dducret/WindSpots-Hardware/build/SensorCard/SensorCard.jpg

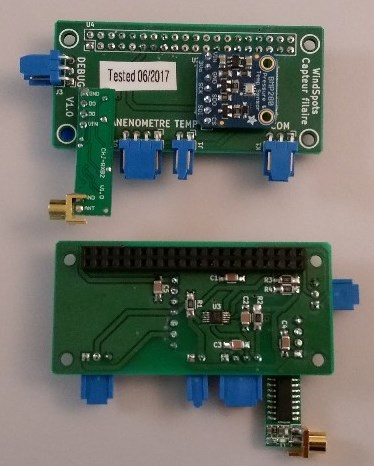
build/SensorCard/SensorCard.jpg
