dducret/WindSpots-Hardware/documentation/Connection Console.jpg

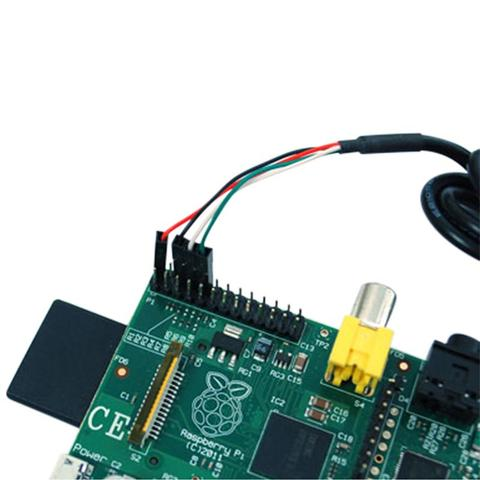
documentation/Connection Console.jpg
