dducret/WindSpots-Hardware/README.md

# WindSpots-Hardware
All information, schema, source code for building a WindSpots Weather Station
