dducret/WindSpots-Hardware/documentation/README.md

# Documentation WindSpots MeteoStation

Ce repertoire regroupe la documentation d'installation, d'exploitation et de maintenance de la station meteo WindSpots.

## Guides disponibles

- [Installation de base sur Raspberry Pi 3](installation-base-raspberry-pi-3.md)
- [Interface web de configuration](wui-configuration.md)
- [Initialisation de la base meteo](initwsdb.md)
- [Tests cible apres installation](tests-cible.md)
