dducret/WindSpots-Hardware/documentation/Component WindSpots 2017 v6.xlsx

Sheet: Carte w2rpi
Quantité | Fournisseur | Référence | Description | Prix net | Prix | Total | 47.32
1 | Leiton | PCB - 83307-1 | Carte PCB | 9.00 | 9.95 | 9.95
1 | Farnell | ADS1015IDGST | ADS1015 | 2.75 | 3.50 | 3.50
1 | DigiKey | CONMCX003.031-ND | MCX Antenne | 3.30 | 3.98 | 3.98
3 | Distrelec | 300-56-914 | 10k | 0.03 | 0.03 | 0.09
1 | Distrelec | 300-57-004 | 4.7k | 0.03 | 0.03 | 0.03
5 | Distrelec | 300-66-372 | 100nF | 0.13 | 0.13 | 0.67
1 | RS Components | 125-8208 | QAM-RX10-433 | 2.41 | 2.41 | 2.41
1 | Adafruit | 2651 | BMP280 | 8.96 | 8.96 | 8.96 |  | Mouser | 485-2651 | 9.13
1 | Adafruit | 2243 | barrette 40 pôles | 1.76 | 1.76 | 1.76 |  | Farnell | 1528-1785-ND | 1.33
1 | Distrelec | 143-01-686 | DUBOX 2 pôles | 0.50 | 0.50 | 0.50
2 | Distrelec | 143-01-687 | DUBOX 3 pôles | 0.49 | 0.49 | 0.98
1 | Distrelec | 143-01-688 | DUBOX 4 pôles | 0.77 | 0.77 | 0.77
1 | Distrelec | 143-01-700 | DUBOX femelle 2 pôles | 0.21 | 0.21 | 0.21
2 | Distrelec | 143-01-701 | DUBOX femelle 3 pôles | 0.21 | 0.21 | 0.42
1 | Distrelec | 143-01-702 | DUBOX femelle 4 pôles | 0.34 | 0.34 | 0.34
12 | Distrelec | 143-01-729 | Sertissage DUBOX femelle | 0.17 | 0.17 | 2.04
1 | Adafruit | 1531 | MCX Jack to BNC | 5.36 | 5.36 | 5.36
1 |  |  | Frais de port | 89.00 | 89.00 | 2.97
1 |  |  | Douane | 71.75 | 71.75 | 2.39

Sheet: Carte Alim
Quantité | Fournisseur | Référence | Description | Prix net | Prix | Total | 51.59
1 | Ecole | PCB | Carte PCB | 10.00 | 10.00 | 10.00
4 | Distrelec | 300-56-914 | 10 k [Ω] | 0.03 | 0.03 | 0.12
1 | Distrelec | 300-56-934 | 2 k [Ω] | 0.03 | 0.03 | 0.03
1 | Distrelec | 300-37-183 | 0.01 [Ω] 3W | 0.95 | 0.95 | 0.95
1 | Farnell | 2139689 | 910k [Ω] | 0.08 | 0.08 | 0.08
1 | Distrelec | 300-37-190 | 0.1 [Ω] 0.3W | 0.25 | 0.25 | 0.25
1 | Distrelec | 300-56-936 | 220 [Ω] | 0.03 | 0.03 | 0.03
2 | Distrelec | 300-56-984 | 10 [Ω] | 0.03 | 0.03 | 0.05
1 | Distrelec | 300-37-189 | 0.1 [Ω] 3 W | 0.95 | 0.95 | 0.95
6 | Distrelec | 300-66-372 | 100 nF | 0.11 | 0.11 | 0.68
3 | Distrelec | 300-66-117 | 10 uF | 0.13 | 0.13 | 0.40
1 | Farnell | 9227865 | 1uF | 0.14 | 0.14 | 0.14
2 | Distrelec | 300-13-748 | 100uF | 0.38 | 0.38 | 0.77
1 | Distrelec | 173-04-265 | 555 | 0.22 | 0.22 | 0.22
1 | Farnell | 1470502 | PTH080880 | 8.57 | 8.57 | 8.57
1 | Distrelec | 300-55-984 | MCP1826 | 0.77 | 0.77 | 0.77 |  | Farnell | 1578424 | 0.57
5 | Farnell | 2496402 | INA219 | 1.98 | 1.98 | 9.90
5 | Distrelec | 148-40-952 | BORNIER 2 pôles | 0.59 | 0.59 | 2.95
1 | Distrelec | 142-70-880 | port USB | 1.05 | 1.05 | 1.05
2 | Distrelec | 300-43-381 | support fusible | 0.39 | 0.39 | 0.79
1 | Distrelec | 143-01-686 | DUBOX 2 pôles | 0.50 | 0.50 | 0.50
1 | Distrelec | 143-01-687 | DUBOX 3 pôles | 0.49 | 0.49 | 0.49
1 | Distrelec | 175-22-735 | Phototransistor | 0.25 | 0.25 | 0.25
2 | Distrelec | 300-57-629 | Diode schottky PMEG6010CEH | 0.31 | 0.31 | 0.62
1 | Distrelec | 170-10-283 | Diode schottky 1N5819 | 0.26 | 0.26 | 0.26
1 | Distrelec | 164-36-000 | Potentiomètre | 0.39 | 0.39 | 0.39
1 | Distrelec | 171-01-432 | MOSFET BSP76 | 0.81 | 0.81 | 0.81
1 | Distrelec | 300-43-490 | Fusible 2 A | 0.20 | 0.20 | 0.20
1 | Distrelec | 133-16-866 | Fusible 15 A | 0.30 | 0.30 | 0.30
1 | Distrelec | 143-01-700 | DUBOX femelle 2 pôles | 0.21 | 0.21 | 0.21
1 | Distrelec | 143-01-701 | DUBOX femelle 3 pôles | 0.21 | 0.21 | 0.21
5 | Distrelec | 143-01-729 | Sertissage DUBOX femelle | 0.17 | 0.17 | 0.85
1 | Distrelec | 148-15-663 | Socle 555 | 1.00 | 1.00 | 1.00
1 |  |  | Frais de port | 34.05 | 34.05 | 6.81
1 |  |  | Douane | 0 | 0 | 0

Sheet: WS Station
Quantité | Fournisseur | Référence | Description | Prix net | Total | 314.62
1 | Farnell | 2525225 | Raspberry PI 3 | 35.29 | 35.29
1 | Distrelec |  | Carte Micro SD 4GB | 5.13 | 5.13
1 | WindSpots | WS200 | w2rpi | 47.32 | 47.32
1 | FNAC |  | Lentille UV 52mm | 17.90 | 17.90
1 | Conrad | 284324-62 | Capteur de température MJSPJY-223-3950-1-600-3D | 9.95 | 9.95
1 | Perillat SA | M 10 BN 137 | Ecrou petit filletage | 0.25 | 0.25
1 | Alltron | 253525 | Camera Logitech C930e | 102.45 | 102.45
1 | Swibox |  | Boite | 19.70 | 19.70
1 | Radio Matériel | BT-V112 | Support | 23.20 | 23.20
4 |  |  | Rivet pop | 0.20 | 0.80
1 | Promatelec |  | Presse étoupe M16 | 0.75 | 0.75
1 | Distrelec | 303139 | Ventilateur à Membrane | 9.20 | 9.20
1 | Distrelec | 506104 | Ecrou pour Ventilateur M12 x 1.5 | 0.35 | 0.35
1 | Distrelec | 221014 | Prise RJ45 pour Anémomètre filaire M22-RJ45-SA | 28.30 | 28.30
1 | WindSpots |  | Câble RJ11 - Dubox 4 pôles | 1.70 | 1.70
0 | Conrad | 181895 | Sachet absorbeur d'humidité 181895 3 g | 0.17 | 0.00
1 | Adafruit | 1531 | Cable BNC - MCX jack | 5.95 | 5.95
 | Distrelec | 148-01-791 | Entretoise 8mm | 0.35
4 | Distrelec | 148-01-196 | Entretoise 10mm 5mm | 0.44 | 1.75
4 | Distrelec | 148-01-794 | Entretoise 10mm 5mm | 0.35 | 1.39
4 | Distrelec | 110-76-305 | Entretoise 20mm 5mm | 0.67 | 2.67
4 | Distrelec | 110-76-375 | Vis tete fendue 6mm | 0.14 | 0.55
0 | Distrelec | 300-71-990 | Vis tete philipps 8mm / 100 pièces | 4.60 | 0.00
 | Distrelec | 300-71-989 | Vis tete philipps 10mm / 100 pièces | 3.00 | 0.00
 | Distrelec | 301-13-355 | Presse etoupe M 12 | 1.47 | 0.00
 | Distrelec | 301-13-356 | Presse etoupe M 16 | 1.79 | 0.00

Sheet: Options
Quantité | Fournisseur | Référence | Description | Prix net | Total
STATION | WindSpots |  | Station de Base |  | 314.62 | 314.62
SOLAIRE |  |  |  |  |  | 307.67
1 | Conrad | 1216562 | Phocos 321199 | 48.10 | 48.10
1 | Conrad | 250914 | Batterie Plomb 12V 5aH | 36.99 | 36.99
1 | WindSpots | WS300 | Alimentation WindSpots | 51.59 | 51.59
1 | Distrelec | 155-18-890 | Presse Etoupe PG11 4...10 mm 8 mm | 0.99 | 0.99
1 |  |  | Panneau Solaire 20W | 120.00 | 120.00
1 |  |  | Support Panneau Solaire (Antenne Satelitte) | 50.00 | 50.00
POE |  |  |  |  |  | 145.30
1 | Digitec | 353093 | Trendnet TPE-113GI, Gigabit PoE-Injector | 33.70 | 33.70
1 | Digitec | 5656488 | Trendnet TPE-104GS Gigabit PoE | 35.40 | 35.40
1 | Adafru.it | 2727 | Jack to microUSB | 2.5 | 2.50
1 | Maxxtro | 125-11-222 | Network cable | 7.1 | 7.10
1 | Distrelec | 144-67-015 | Fiche RJ45 Accouplement | 30.9 | 30.90
1 | Distrelec | 144-67-007 | Douille RJ45 | 15.7 | 15.70
20 |  |  | Cable RJ45 | 1 | 20.00
220V |  |  |  |  |  | 28.73
1 | Distrelec | 169-05-904 | Bloc d'alimentation | 11.90 | 11.90
1 | Conrad | 595240 | MicroUsb adaptater | 5.90 | 5.90
2 | Distrelec | 155-18-890 | Presse Etoupe PG11 4...10 mm 8 mm | 0.99 | 1.98
1 | Distrelec | 300-64-471 | Boite | 4.35 | 4.35
5 | Distrelec | 155-91-519 | Cable coax | 0.92 | 4.60
3G |  |  |  |  |  | 166.70
1 | Alltron | 236872 | USB 3G | 41.40 | 41.40
1 | Alltron | 237516 | Coax pgtail for 3G | 17.75 | 17.75
1 | Alltron | 175002 | GSM Antenne 3G | 107.55 | 107.55
433Mhz |  |  |  |  |  | 380.95
1 | Radioworld.ca | WMR200 | Oregon WMR 200 + Port | 350.00 | 350.00
1 | Conrad | 115142 | Petite Antenne | 30.95 | 30.95
0 | Conrad | 190073 | Moyenne Antenne | 50.95 | 0.00
0 | Aquatel | AQ920-7 | Antenna Booster Kit | 135.00 | 0.00
Filaire |  |  |  |  |  | 155.00
1 | Meteo-Shop.ch | 6410 | Anémomètre Davis Vantage Pro2 | 155.00 | 155.00
