dducret/WindSpots-Hardware/build/SensorCard/SensorCard-Schema.pdf

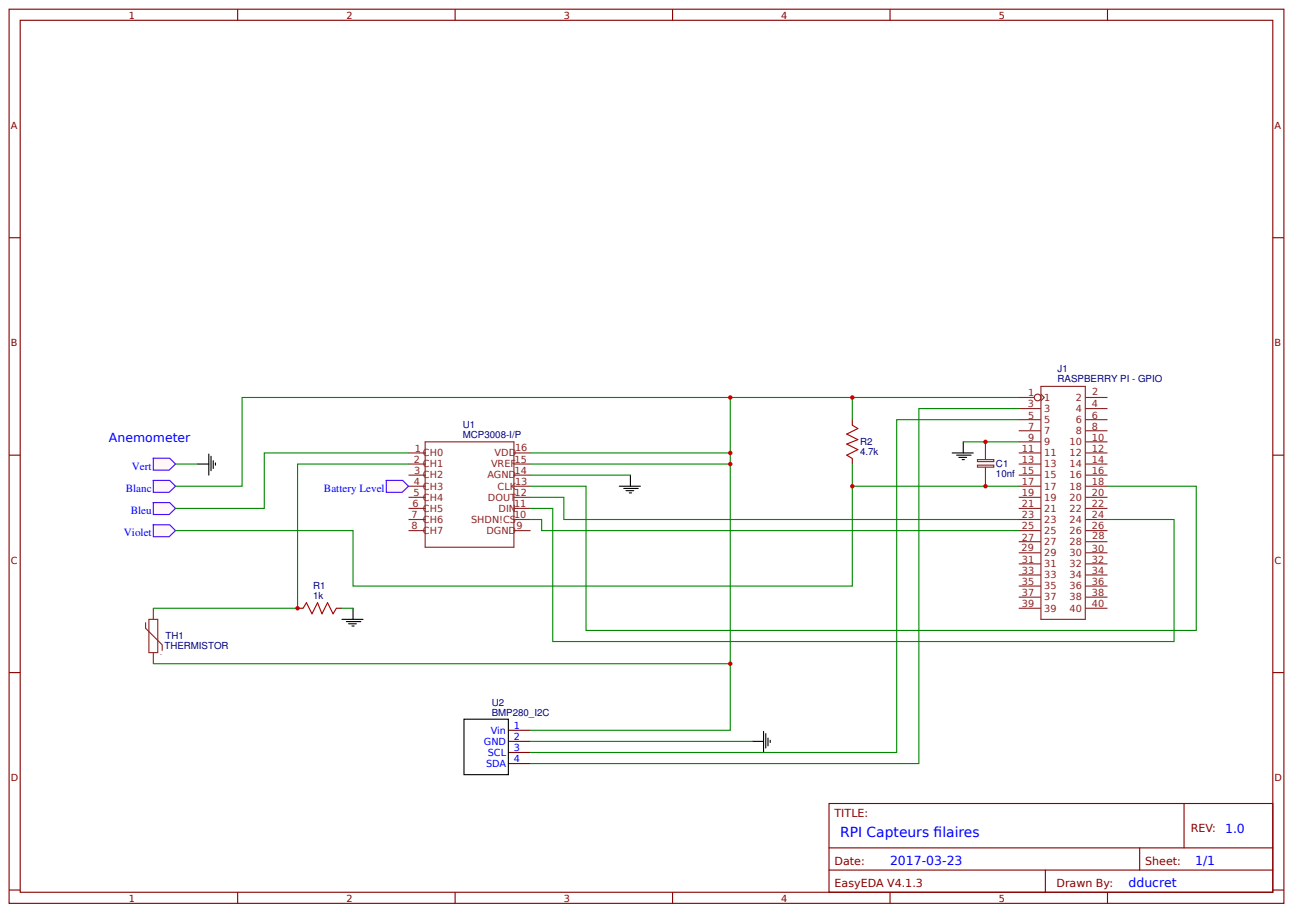
[picture p3: page 1]
TITLE:; RPI Capteurs filaires; REV: 1.0; Date:; Sheet: 1/1; EasyEDA V4.1.3; Drawn By:; dducret; MCP3008-I/P; DGND9 SHDN!CS10 DIN11 DOUT12 CLK13 AGND14 VREF15 VDD16; Vert; Blanc; Bleu; Violet; Anemometer; BMP280_I2C; Vin 1 GND 2 SCL 3 SDA 4; RASPBERRY PI - GPIO; THERMISTOR; Battery Level
