dducret/WindSpots-Hardware/documentation/Schema_alimentation_panneau_solaire.pdf

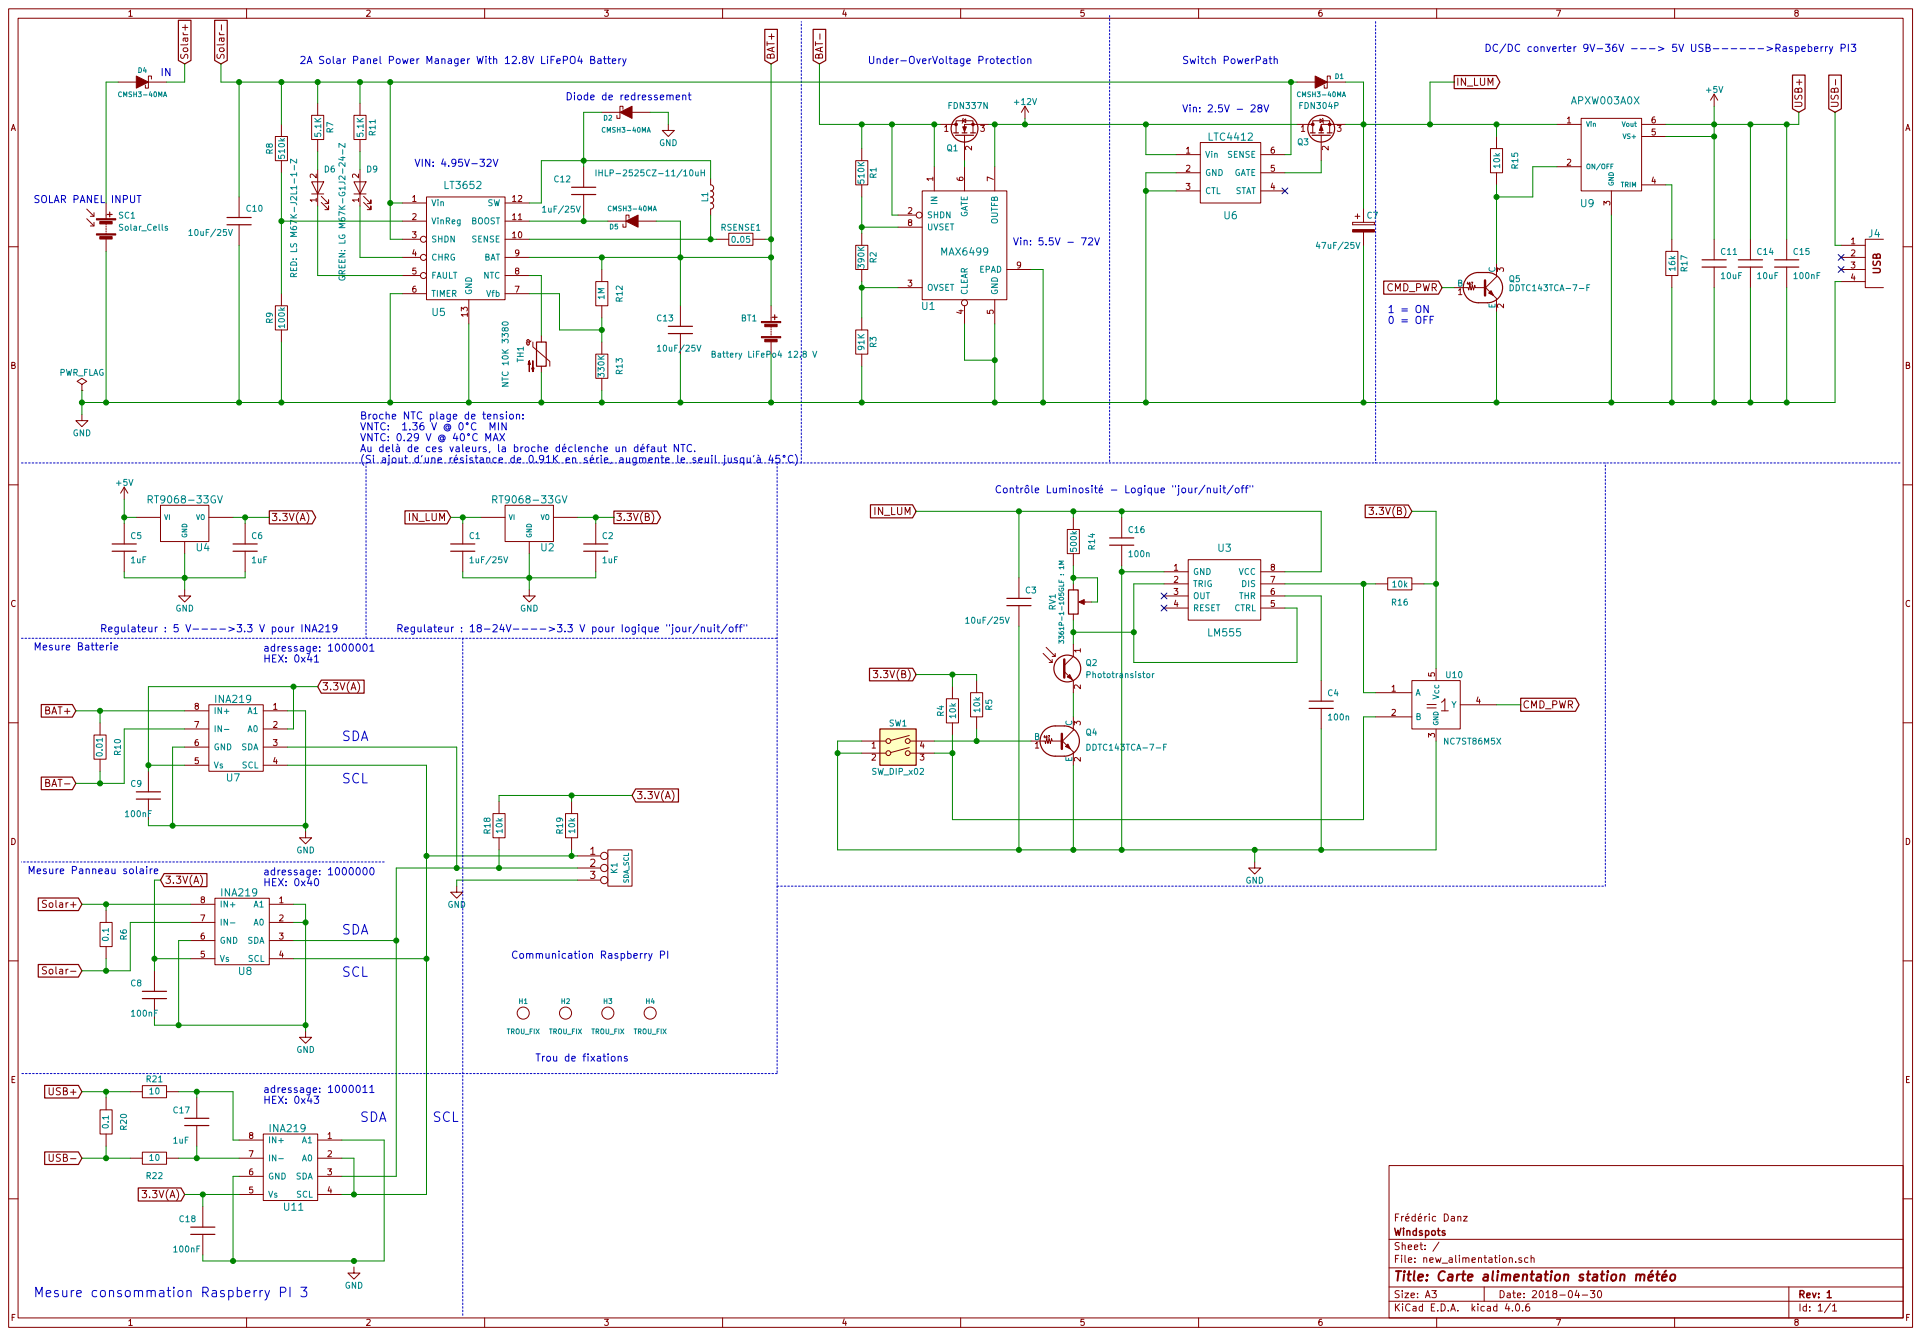
[picture p4: page 1]

DC/DC converter 9V-36V ---> 5V USB------>Raspeberry PI3

1 2D9 GREEN: LG M67K-G1J2-24-Z 1 2D6 RED: LS M67K-J2L1-1-Z 5.1K R7 5.1K R11 D5CMSH3-40MA BT1 Battery LiFePo4 12.8 V Mesure Panneau solaire

47uF/25V Broche NTC plage de tension:

10uF Regulateur : 18-24V---->3.3 V pour Iogique "jour/nuit/off"

(Si ajout d'une résistance de 0.91K en série, augmente le seuil jusqu'à 45°C) TH1 NTC 10K 3380

VNTC: 1.36 V @ 0°C MIN
VNTC: 0.29 V @ 40°C MAX
Au delà de ces valeurs, la broche déclenche un défaut NTC.

LM555 Contrôle Luminosité - Logique "jour/nuit/off"

1 2 Q2Phototransistor GND GND GND GND GND SDA

File: new_alimentation.sch Sheet: / Windspots Frédéric Danz

Id: 1/1 Title: Carte alimentation station météo
