dducret/WindSpots-Hardware/build/SolarPowerCard/Schema.pdf

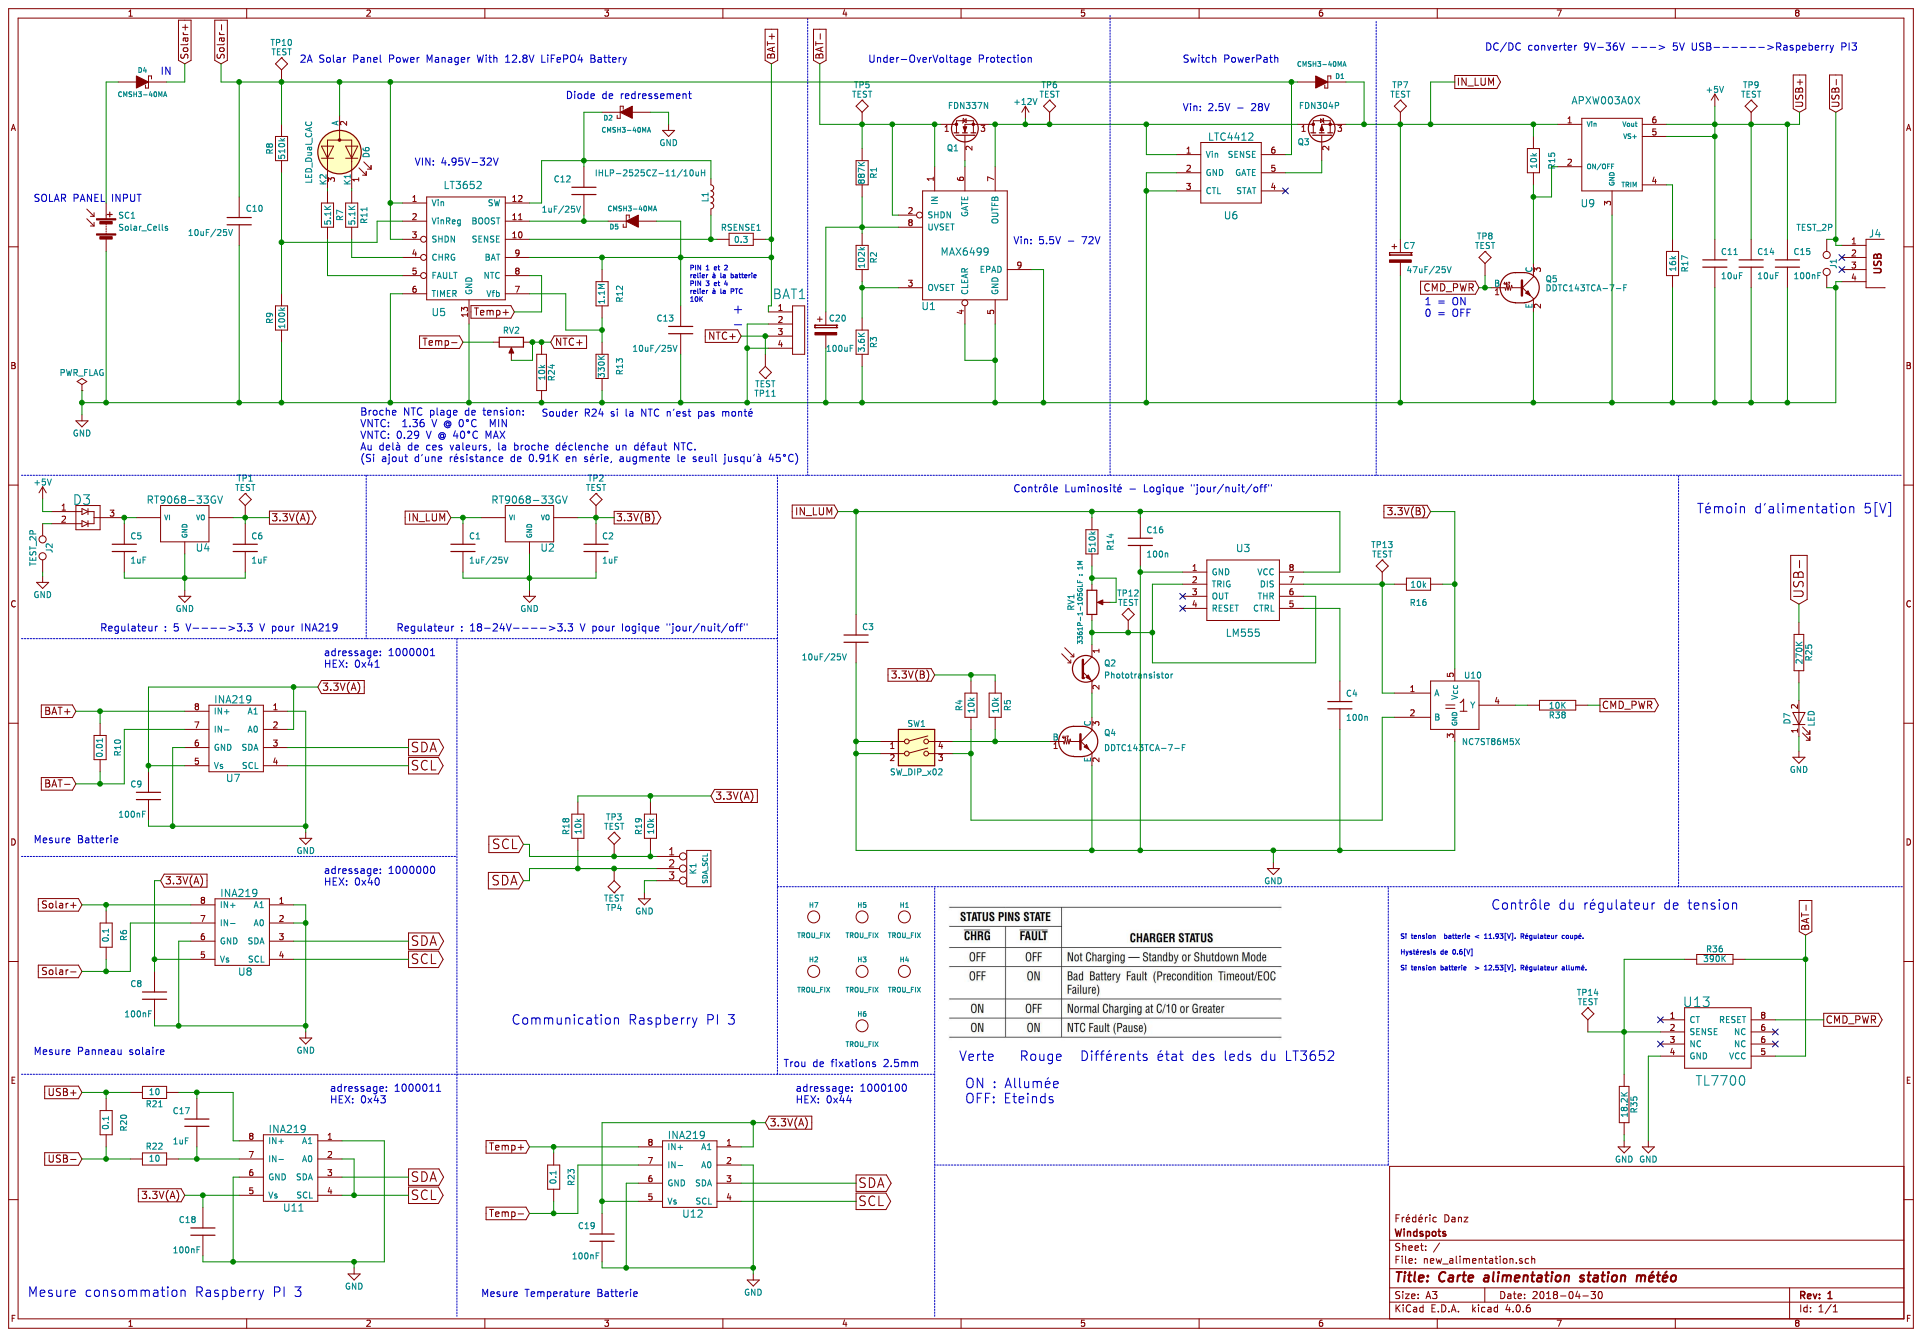
[picture p5: page 1]
