dducret/WindSpots-Hardware/documentation/RPI_capteur_filaires.pdf

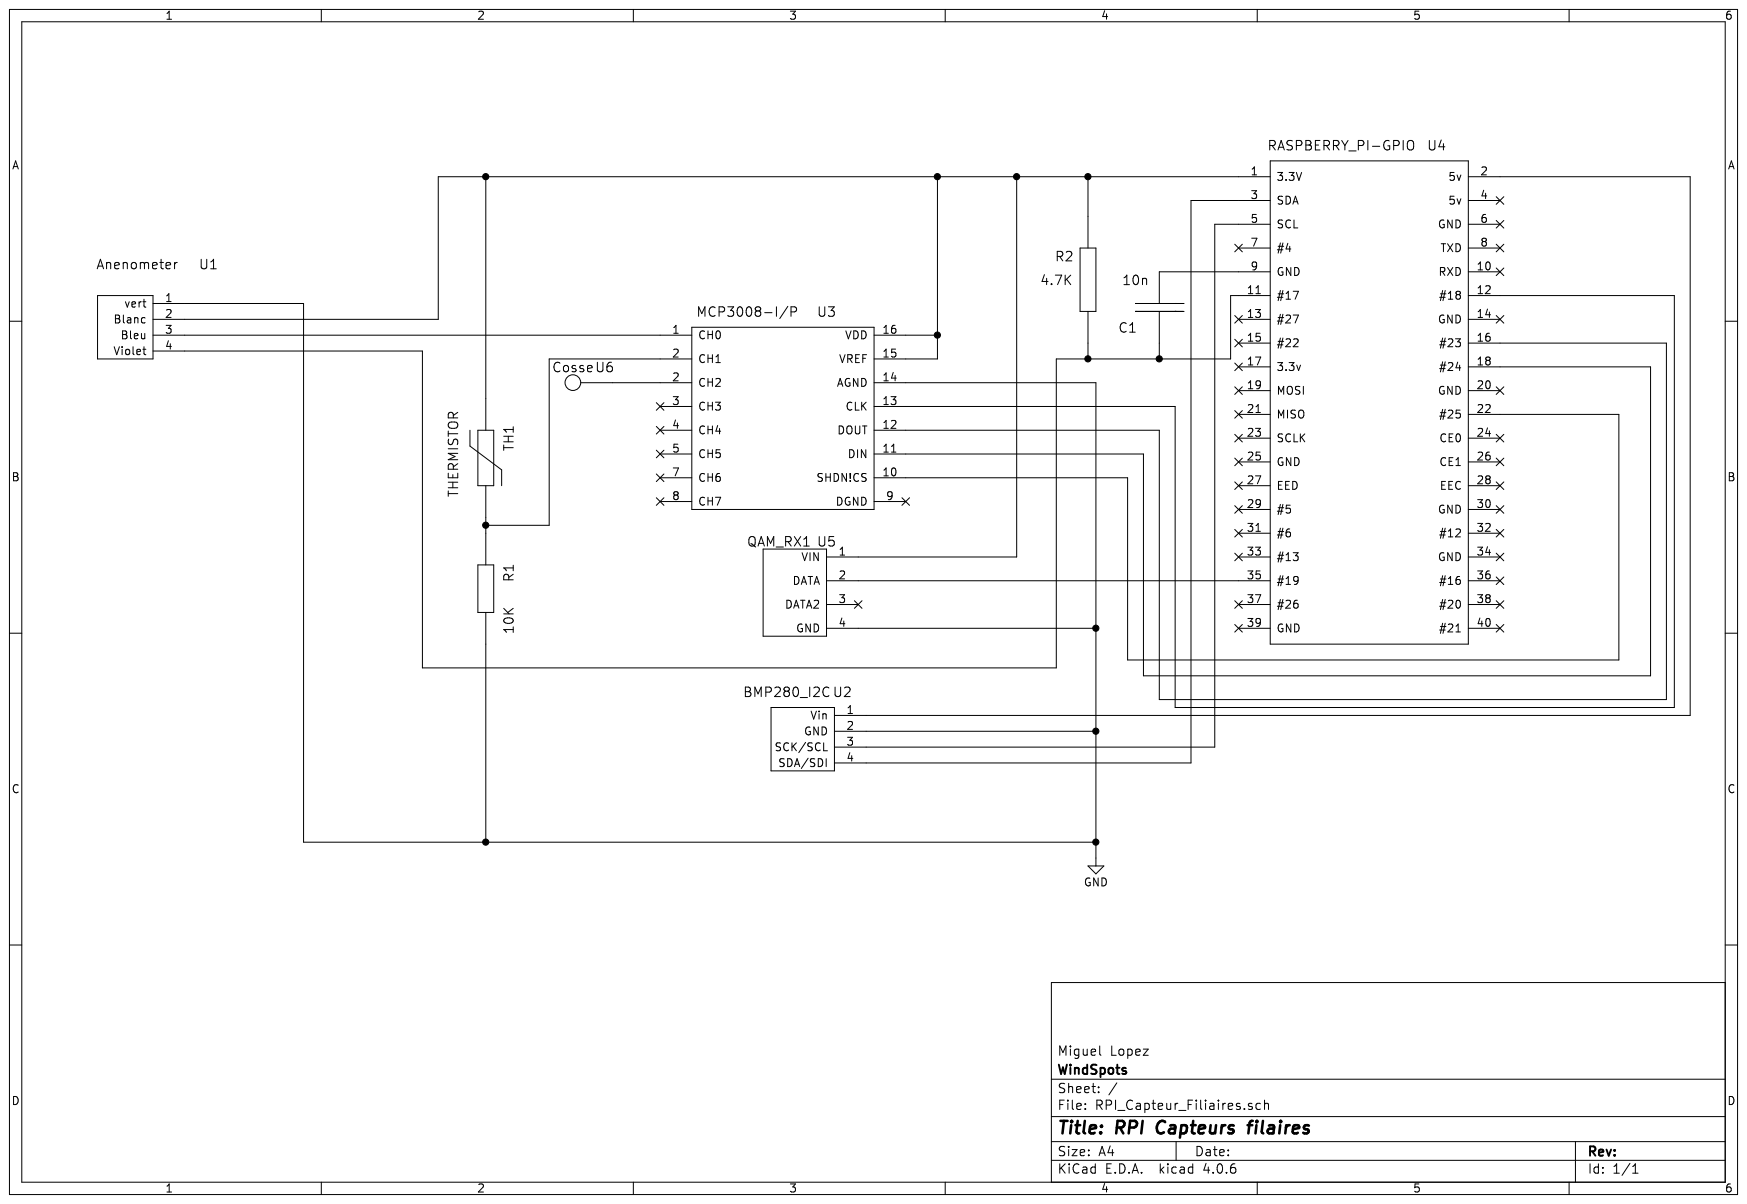
[picture p6: page 1]
