dducret/WindSpots-Hardware/build/SensorCard/SensorCard.sch

## KiCad design build/SensorCard/SensorCard.sch (2026-01-21)

Schematic: SensorCard.sch

Parts:
C1, C2, C3, C4, C5: 100n; C_1206_HandSoldering
H1, H2, H3, H4: TROU_FIX; TROU_3.5
J1: CON_THERMISTOR; Pin_Header_Angled_1x02_Pitch2.54mm
J3: DEBUG; Pin_Header_Angled_1x03_Pitch2.54mm
K1: SDA_SCL; Pin_Header_Angled_1x03_Pitch2.54mm
R1, R3, R4: 10k; R_1206_HandSoldering
R2: 4.7k; R_1206_HandSoldering
U1: Anémomètre; Pin_Header_Angled_1x04_Pitch2.54mm
U2: BMP280_I2C; Pin_Header_Straight_1x07_Pitch2.54mm
U3: ads1015; ADS1015
U4: RASPBERRY_PI-GPIO; Pin_Header_Straight_2x20_Pitch2.54mm
U5: QAM-RX10-433; Pin_Header_Straight_1x04_Pitch2.54mm

Notes on the sheet:
Addressage : 1001000 HEX : 0x48
addressage? pas reglable... addresse defaut : 0x77 // 0x76
