dducret/WindSpots-Hardware/build/SolarPowerCard/new_alimentation.sch

## KiCad design build/SolarPowerCard/new_alimentation.sch (2026-01-15)

Schematic: new_alimentation.sch

Parts:
BAT1: TERM_BLOCK_4POS
C1, C12: 1uF/25V; C_0805_HandSoldering
C2, C5, C6, C17: 1uF; C_0805_HandSoldering
C3, C10, C13: 10uF/25V; C_0805_HandSoldering
C4, C16: 100n; C_0805_HandSoldering
C7: 47uF/25V; CP_Elec_6.3x5.8
C8, C9, C15, C18, C19: 100nF; C_0805_HandSoldering
C11, C14: 10uF; C_0805_HandSoldering
C20: 100uF
D1, D2, D4, D5: CMSH3-40MA; D_SMA
D3: MMBD5004C-7; SOT-23
D6: LED_Dual_CAC; TERM_BLOCK_3POS
D7: LED; LED_0805_HandSoldering
H1, H2, H3, H4, H5, H6, H7: TROU_FIX; TROU_2.5
J1, J2: TEST_2P; Pin_header_1x2
J4: USB_2; USB
K1: SDA_SCL; TERM_BLOCK_3POS
L1: IHLP-2525CZ-11/10uH; L_Vishay_IHLP-2525
Q1: FDN337N; SOT-23
Q2: Phototransistor; TERM_BLOCK_2POS
Q3: FDN304P; SOT-23
Q4, Q5: DDTC143TCA-7-F; SOT-23
R1: 887K; R_1206_HandSoldering
R2: 102k; R_1206_HandSoldering
R3: 3.6K; R_1206_HandSoldering
R4, R5, R15, R16, R18, R19: 10k; R_1206_HandSoldering
R6, R20, R23: 0.1; R_1206_HandSoldering
R7, R11: 5.1K; R_1206_HandSoldering
R8, R14: 510k; R_1206_HandSoldering
R9: 100k; R_1206_HandSoldering
R10: 0.01; R_1206_HandSoldering
R12: 1.1M; R_1206_HandSoldering
R13: 330K; R_1206_HandSoldering
R17: 16k; R_1206_HandSoldering
R21, R22: 10; R_1206_HandSoldering
R24: 10k; R_1206
R25: 270; R_1206_HandSoldering
R35: 18.2K; R_1206
R36: 390K; R_1206
R38: 10K; R_1206
RSENSE1: 0.3; R_1206_HandSoldering
RV1: 3361P-1-105GLF : 1M; POT_SMD_Bourns_3361P
RV2: POT; Pot_smd_bourns
SC1: Solar_Cells; TERM_BLOCK_2POS
SW1: SW_DIP_x02; SW_DIP_x2_W8.61mm_Slide_LowProfile
TP1, TP2, TP3, TP4, TP5, TP6, TP7, TP8, TP9, TP10, TP11, TP12, TP13, TP14: TEST; test_point
U1: MAX6499; DFN-8-1EP_3x3mm_Pitch0.65mm
U2, U4: RT9068-33GV; SOT-23
U3: LM555; SOIC-8-N
U5: LT3652; LT3652EMSE-PBF
U6: LTC4412; TSOT-23-6_HandSoldering
U7, U8, U11, U12: INA219; SOIC-8-N
U9: APXW003A0X
U10: NC7ST86M5X; SOT-23-5_HandSoldering
U13: TL7700; SO-8_5.3x6.2mm_Pitch1.27mm

Notes on the sheet:
Switch PowerPath
Under-OverVoltage Protection
2A Solar Panel Power Manager With 12.8V LiFePO4 Battery
Regulateur : 5 V---->3.3 V pour INA219
adressage: 1000000 HEX: 0x40
Mesure Batterie
adressage: 1000001 HEX: 0x41
Contrôle Luminosité - Logique "jour/nuit/off"
DC/DC converter 9V-36V ---> 5V USB------>Raspeberry PI3
SOLAR PANEL INPUT
Trou de fixations 2.5mm
Vin: 5.5V - 72V
Vin: 2.5V - 28V
VIN: 4.95V-32V
Regulateur : 18-24V---->3.3 V pour Iogique "jour/nuit/off"
1 = ON 0 = OFF
Diode de redressement
adressage: 1000011 HEX: 0x43
Mesure consommation Raspberry PI 3
Broche NTC plage de tension: VNTC: 1.36 V @ 0°C MIN VNTC: 0.29 V @ 40°C MAX Au delà de ces valeurs, la broche déclenche un défaut NTC. (Si ajout d'une résistance de 0.91K en série, augmente le seuil jusqu'à 45°C)
Mesure Panneau solaire
Communication Raspberry PI 3
Différents état des leds du LT3652
Verte
Rouge
ON : Allumée OFF: Eteinds
adressage: 1000100 HEX: 0x44
Mesure Temperature Batterie
Contrôle du régulateur de tension
Si tension batterie < 11.93[V]. Régulateur coupé. Hystéresis de 0.6[V] Si tension batterie > 12.53[V]. Régulateur allumé.
Souder R24 si la NTC n'est pas monté
PIN 1 et 2 relier à la batterie PIN 3 et 4 relier à la PTC 10K
Témoin d'alimentation 5[V]
