dducret/WindSpots-Hardware/(commit log)

2026-01-15 Add files via upload
    sch file
    [new_alimentation.sch]
2026-02-12 Replaced wiringpi with pigpio
    [eventManager.cpp, eventManager.h, w3rpi.cpp]
2026-02-19 Update process-camera.sh
    V10.0
2026-02-23 Update install.sh
    Rollback with raspi-config for i2c
2026-07-18 UART enable
